Almisuifre/Malemort/Chronogrammes/Chronogramme PN Malemort/Chronogramme 1 (Brive vers Tulle).jpeg

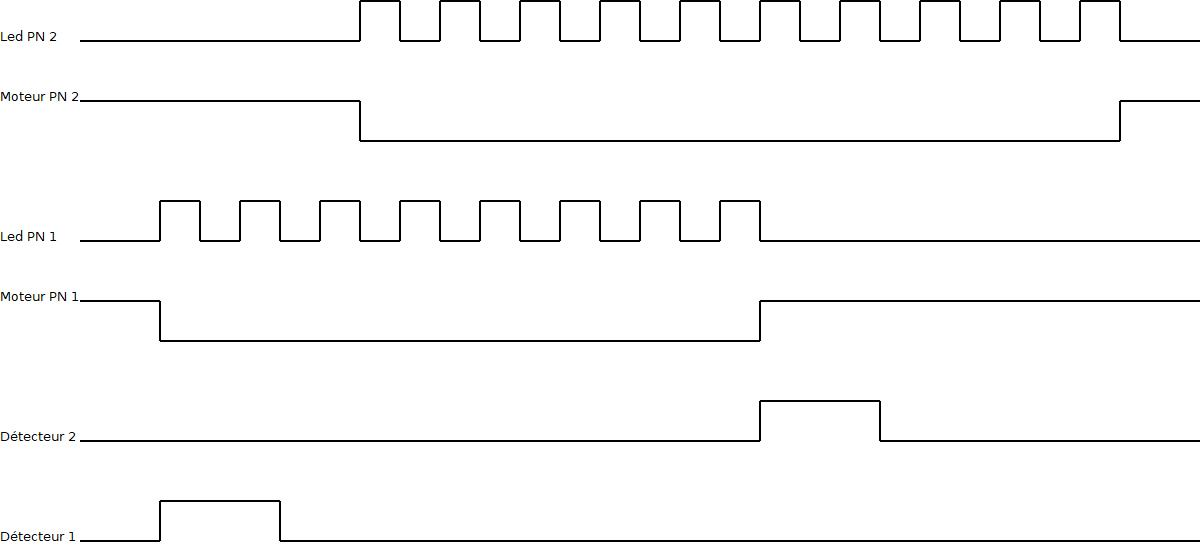
Chronogrammes/Chronogramme PN Malemort/Chronogramme 1 (Brive vers Tulle).jpeg
