Almisuifre/Malemort/Electronique/Eagle/DoublePN/DoublePN-11092017-001.brd

## EAGLE design Electronique/Eagle/DoublePN/DoublePN-11092017-001.brd (2017-09-15)

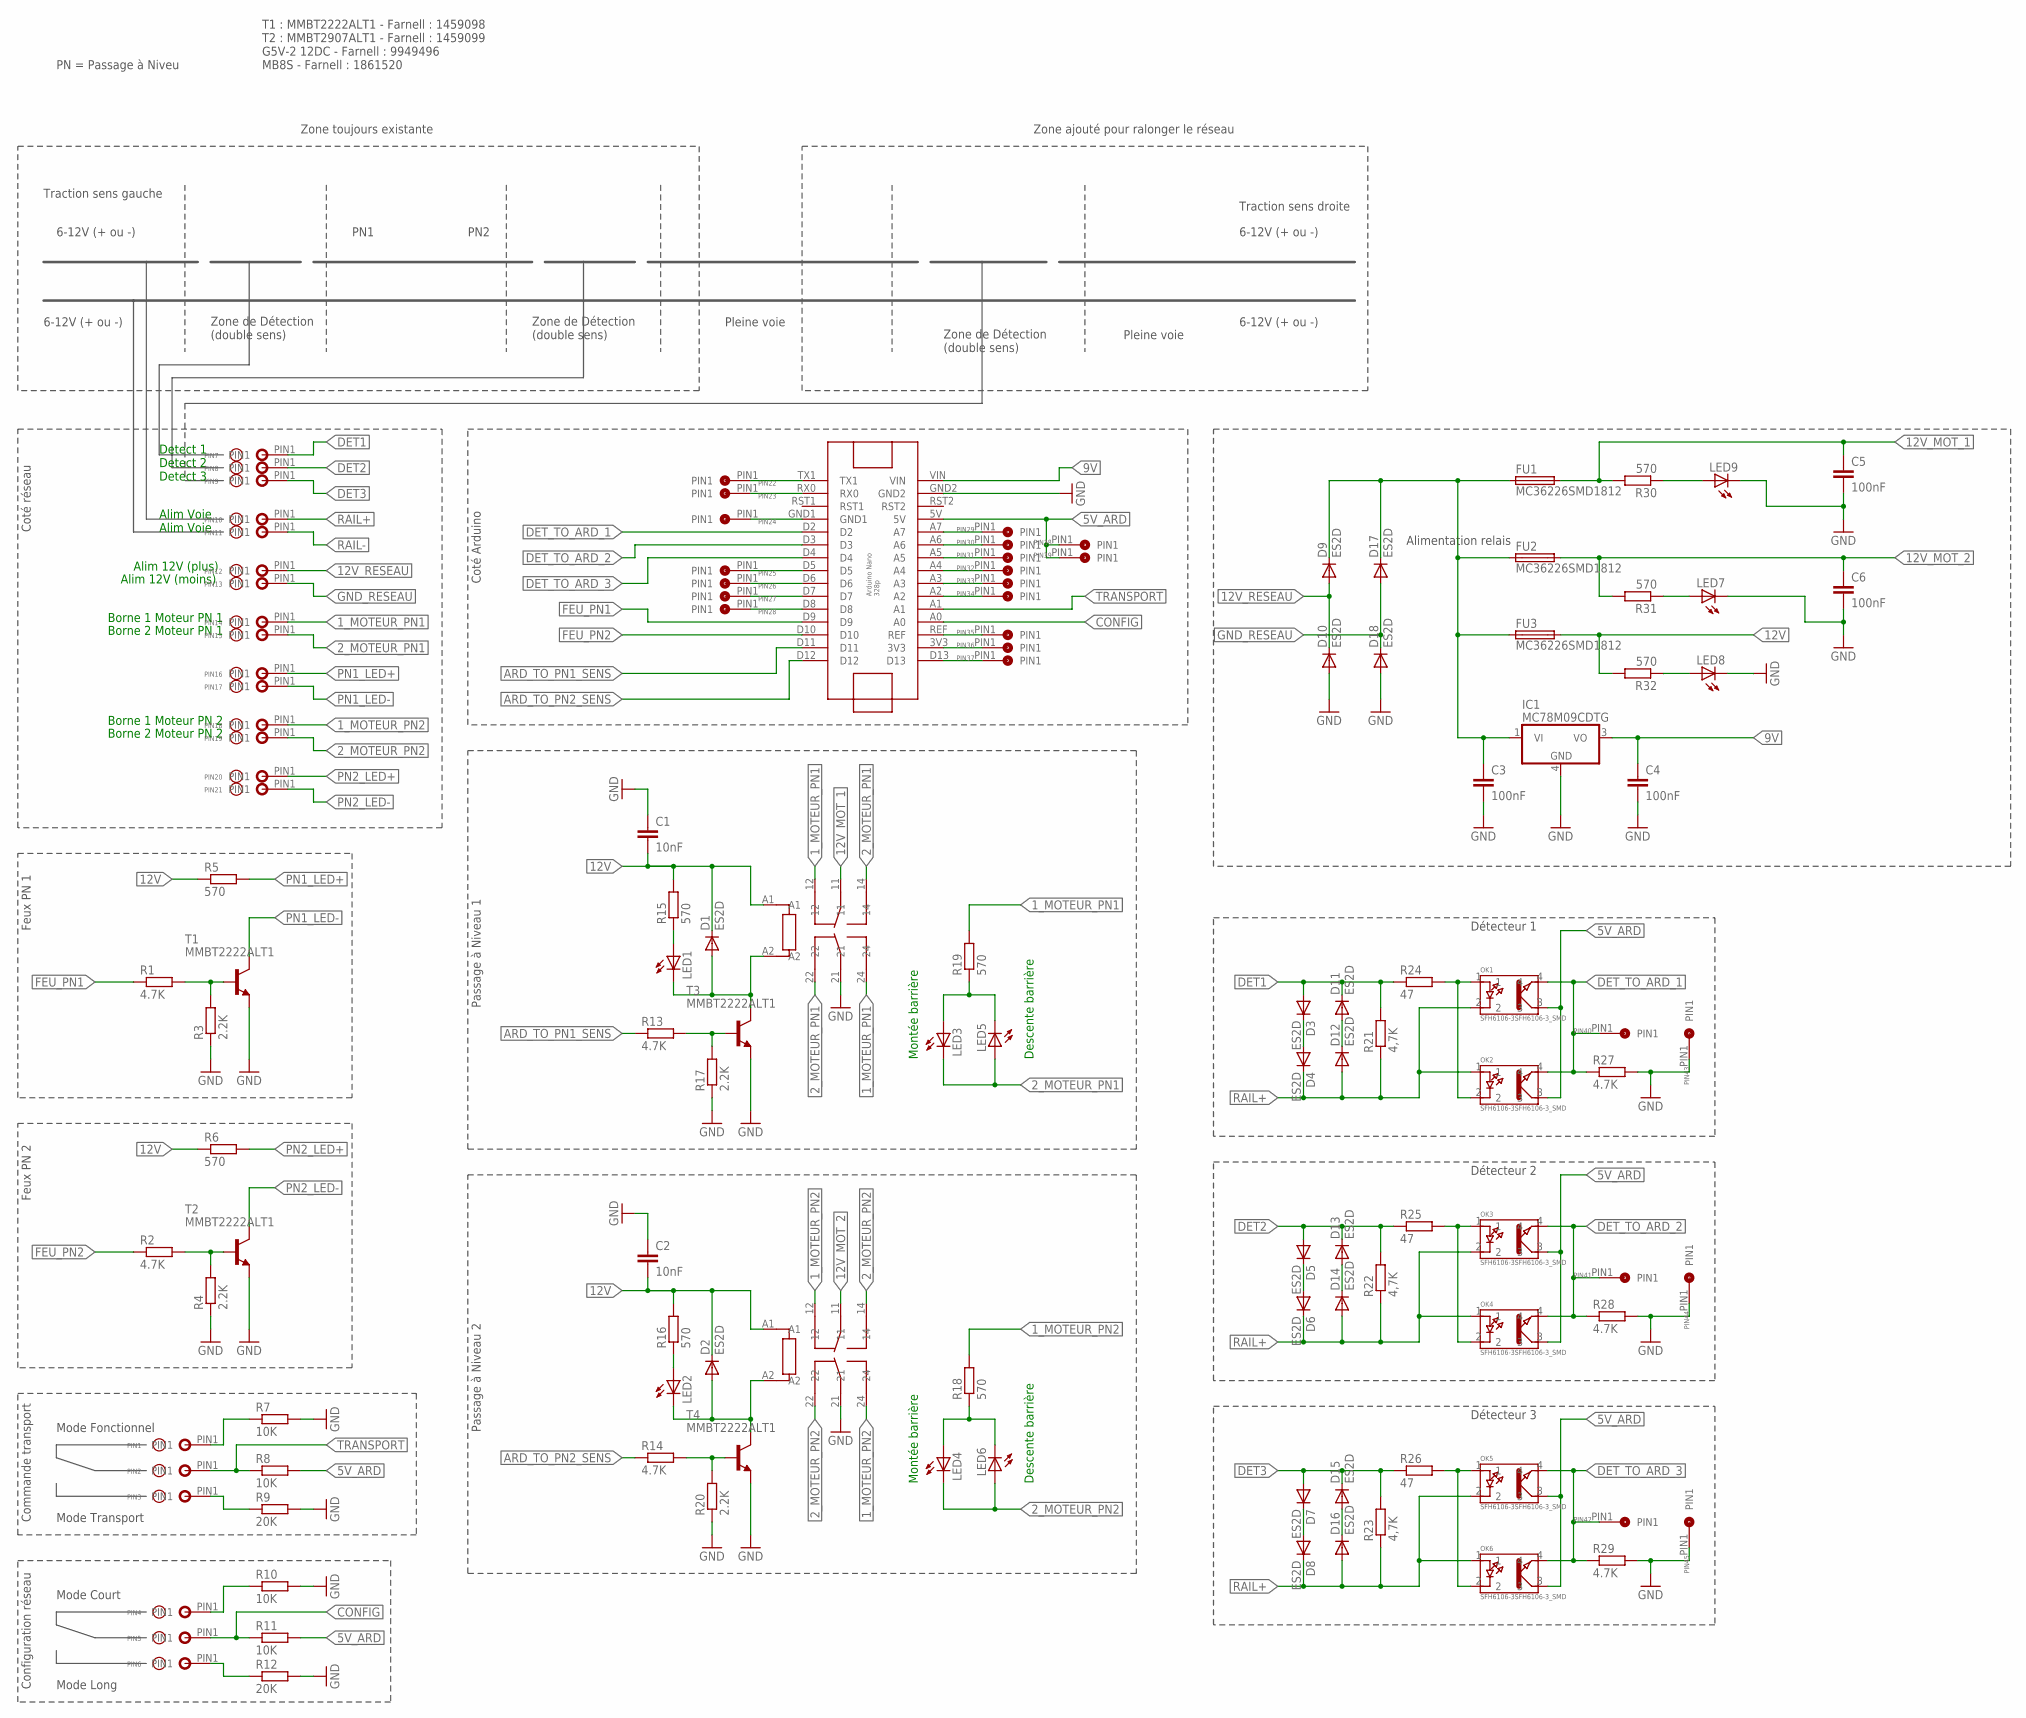
[picture p2: schematic DoublePN-11092017-001.sch]

Parts:
ARDUINO-NANO1: ARDUINO-NANO
C1, C2: 10nF; C0805
C3, C4, C5, C6: 100nF; C0805
D1, D2, D3, D4, D5, D6, D7, D8, D9, D10, D11, D12, D13, D14, D15, D16, D17, D18: ES2D; SMB
FU1, FU2, FU3: MC36226SMD1812; MC36226
IC1: MC78M09CDTG; DPACK_3
LED1, LED2, LED3, LED4, LED5, LED6, LED7, LED8, LED9: LEDCHIPLED_0805; CHIPLED_0805
OK1, OK2, OK3, OK4, OK5, OK6: SFH6106-3SFH6106-3_SMD; SFH6106-3
PIN1, PIN2, PIN3, PIN4, PIN5, PIN6, PIN7, PIN8, PIN9, PIN10, PIN11, PIN12, PIN13, PIN14, PIN15, PIN16, PIN17, PIN18, PIN19, PIN20, PIN21: CON-FILTRAVERSANT-1FILTRAVERSANT-1; CON-FILTRAVERSANT-1
PIN22, PIN23, PIN24, PIN25, PIN26, PIN27, PIN28, PIN29, PIN30, PIN31, PIN32, PIN33, PIN34, PIN35, PIN36, PIN37, PIN38, PIN39, PIN40, PIN41, PIN42, PIN43, PIN44, PIN45: CON-TRAV-1PIN; CON-TRAV-1
R1, R2, R13, R14, R27, R28, R29: 4.7K; R0805
R3, R4, R17, R20: 2.2K; R0805
R5, R6, R15, R16, R18, R19, R30, R31, R32: 570; R0805
R7, R8, R10, R11: 10K; R0805
R9, R12: 20K; R0805
R21, R22, R23: 4,7K; R0805
R24, R25, R26: 47; R0805
RLS1, RLS2: FINDER-DPDT-12VFINDER-DPDT-12V; FINDER-DPDT-12V
T1, T2, T3, T4: MMBT2222ALT1; SOT23-BEC

Connections:
1_MOTEUR_PN1: PIN14.PIN1, R19.2, RLS1.12, RLS1.24
1_MOTEUR_PN2: PIN18.PIN1, R18.2, RLS2.12, RLS2.24
2_MOTEUR_PN1: LED3.C, LED5.A, PIN15.PIN1, RLS1.14, RLS1.22
2_MOTEUR_PN2: LED4.C, LED6.A, PIN19.PIN1, RLS2.14, RLS2.22
5V_ARD: ARDUINO-NANO1.5V, OK1.3, OK2.3, OK3.3, OK4.3, OK5.3, OK6.3, PIN38.PIN1, PIN39.PIN1, R8.2, R11.2
9V: ARDUINO-NANO1.VIN, C4.1, IC1.3 (VO)
12V: C1.2, C2.2, D1.C, D2.C, FU3.2, R5.1, R6.1, R15.2, R16.2, R32.2, RLS1.A1, RLS2.A1
12V_MOT_1: C5.1, FU1.2, R30.2, RLS1.11
12V_MOT_2: C6.1, FU2.2, R31.2, RLS2.11
12V_RESEAU: D9.A, D10.C, PIN12.PIN1
ARD_TO_PN1_SENS: ARDUINO-NANO1.D11, R13.1
ARD_TO_PN2_SENS: ARDUINO-NANO1.D12, R14.1
CONFIG: ARDUINO-NANO1.A0, PIN5.PIN1, R11.1
DET1: D3.A, D11.C, PIN7.PIN1, R21.2, R24.1
DET2: D5.A, D13.C, PIN8.PIN1, R22.2, R25.1
DET3: D7.A, D15.C, PIN9.PIN1, R23.2, R26.1
DET_TO_ARD_1: ARDUINO-NANO1.D2, OK1.4, OK2.4, PIN40.PIN1, R27.1
DET_TO_ARD_2: ARDUINO-NANO1.D3, OK3.4, OK4.4, PIN41.PIN1, R28.1
DET_TO_ARD_3: ARDUINO-NANO1.D4, OK5.4, OK6.4, PIN42.PIN1, R29.1
FEU_PN1: ARDUINO-NANO1.D9, R1.1
FEU_PN2: ARDUINO-NANO1.D10, R2.1
GND: ARDUINO-NANO1.GND2, C1.1, C2.1, C3.2, C4.2, C5.2, C6.2, D10.A, D18.A, IC1.4 (GND), LED7.C, LED8.C, LED9.C, PIN43.PIN1, PIN44.PIN1, PIN45.PIN1, R3.1, R4.1, R7.2, R9.2, R10.2, R12.2, R17.1, R20.1, R27.2, R28.2, R29.2, RLS1.21, RLS2.21, T1.E, T2.E, T3.E, T4.E
GND_RESEAU: D17.A, D18.C, PIN13.PIN1
unnamed: OK1.1, OK2.2, R24.2
unnamed: D3.C, D4.A
unnamed: D11.A, D12.C
unnamed: LED3.A, LED5.C, R19.1
unnamed: R13.2, R17.2, T3.B
unnamed: D5.C, D6.A
unnamed: D1.A, LED1.C, RLS1.A2, T3.C
unnamed: D13.A, D14.C
unnamed: LED1.A, R15.1
unnamed: OK3.1, OK4.2, R25.2
unnamed: D7.C, D8.A
unnamed: D15.A, D16.C
unnamed: OK5.1, OK6.2, R26.2
unnamed: D2.A, LED2.C, RLS2.A2, T4.C
unnamed: LED9.A, R30.1
unnamed: LED4.A, LED6.C, R18.1
unnamed: R14.2, R20.2, T4.B
unnamed: LED2.A, R16.1
unnamed: ARDUINO-NANO1.GND1, PIN24.PIN1
unnamed: R2.2, R4.2, T2.B
unnamed: ARDUINO-NANO1.D7, PIN27.PIN1
unnamed: R1.2, R3.2, T1.B
unnamed: ARDUINO-NANO1.D8, PIN28.PIN1
unnamed: LED7.A, R31.1
unnamed: ARDUINO-NANO1.A7, PIN29.PIN1
unnamed: ARDUINO-NANO1.A6, PIN30.PIN1
unnamed: ARDUINO-NANO1.A5, PIN31.PIN1
unnamed: ARDUINO-NANO1.A4, PIN32.PIN1
unnamed: ARDUINO-NANO1.A3, PIN33.PIN1
unnamed: ARDUINO-NANO1.A2, PIN34.PIN1
unnamed: ARDUINO-NANO1.D6, PIN26.PIN1
unnamed: ARDUINO-NANO1.D5, PIN25.PIN1
unnamed: ARDUINO-NANO1.RX0, PIN23.PIN1
unnamed: ARDUINO-NANO1.TX1, PIN22.PIN1
unnamed: PIN4.PIN1, R10.1
unnamed: PIN1.PIN1, R7.1
unnamed: ARDUINO-NANO1.REF, PIN35.PIN1
unnamed: ARDUINO-NANO1.3V3, PIN36.PIN1
unnamed: ARDUINO-NANO1.D13, PIN37.PIN1
unnamed: PIN6.PIN1, R12.1
unnamed: PIN3.PIN1, R9.1
unnamed: C3.1, D9.C, D17.C, FU1.1, FU2.1, FU3.1, IC1.1 (VI)
unnamed: LED8.A, R32.1
PN1_LED+: PIN16.PIN1, R5.2
PN1_LED-: PIN17.PIN1, T1.C
PN2_LED+: PIN20.PIN1, R6.2
PN2_LED-: PIN21.PIN1, T2.C
RAIL+: D4.C, D6.C, D8.C, D12.A, D14.A, D16.A, OK1.2, OK2.1, OK3.2, OK4.1, OK5.2, OK6.1, PIN10.PIN1, R21.1, R22.1, R23.1
RAIL-: PIN11.PIN1
TRANSPORT: ARDUINO-NANO1.A1, PIN2.PIN1, R8.1

Notes on the sheet:
Alim Voie Alim Voie
Detect 1 Detect 2 Detect 3
Traction sens gauche
6-12V (+ ou -)
Traction sens droite
Zone toujours existante
Zone ajouté pour ralonger le réseau
PN2
PN1
PN = Passage à Niveu
Zone de Détection (double sens)
Pleine voie
Coté réseau
Coté Arduino
Détecteur 1
T1 : MMBT2222ALT1 - Farnell : 1459098 T2 : MMBT2907ALT1 - Farnell : 1459099 G5V-2 12DC - Farnell : 9949496 MB8S - Farnell : 1861520
Alim 12V (plus)
Alim 12V (moins)
Alimentation relais
Borne 1 Moteur PN 1
Borne 2 Moteur PN 1
Borne 2 Moteur PN 2
Borne 1 Moteur PN 2
Montée barrière
Descente barrière
Passage à Niveau 1
Feux PN 1
Mode Court
Mode Long
Configuration réseau
Mode Fonctionnel
Mode Transport
Commande transport
Détecteur 2
Détecteur 3
Feux PN 2
Passage à Niveau 2

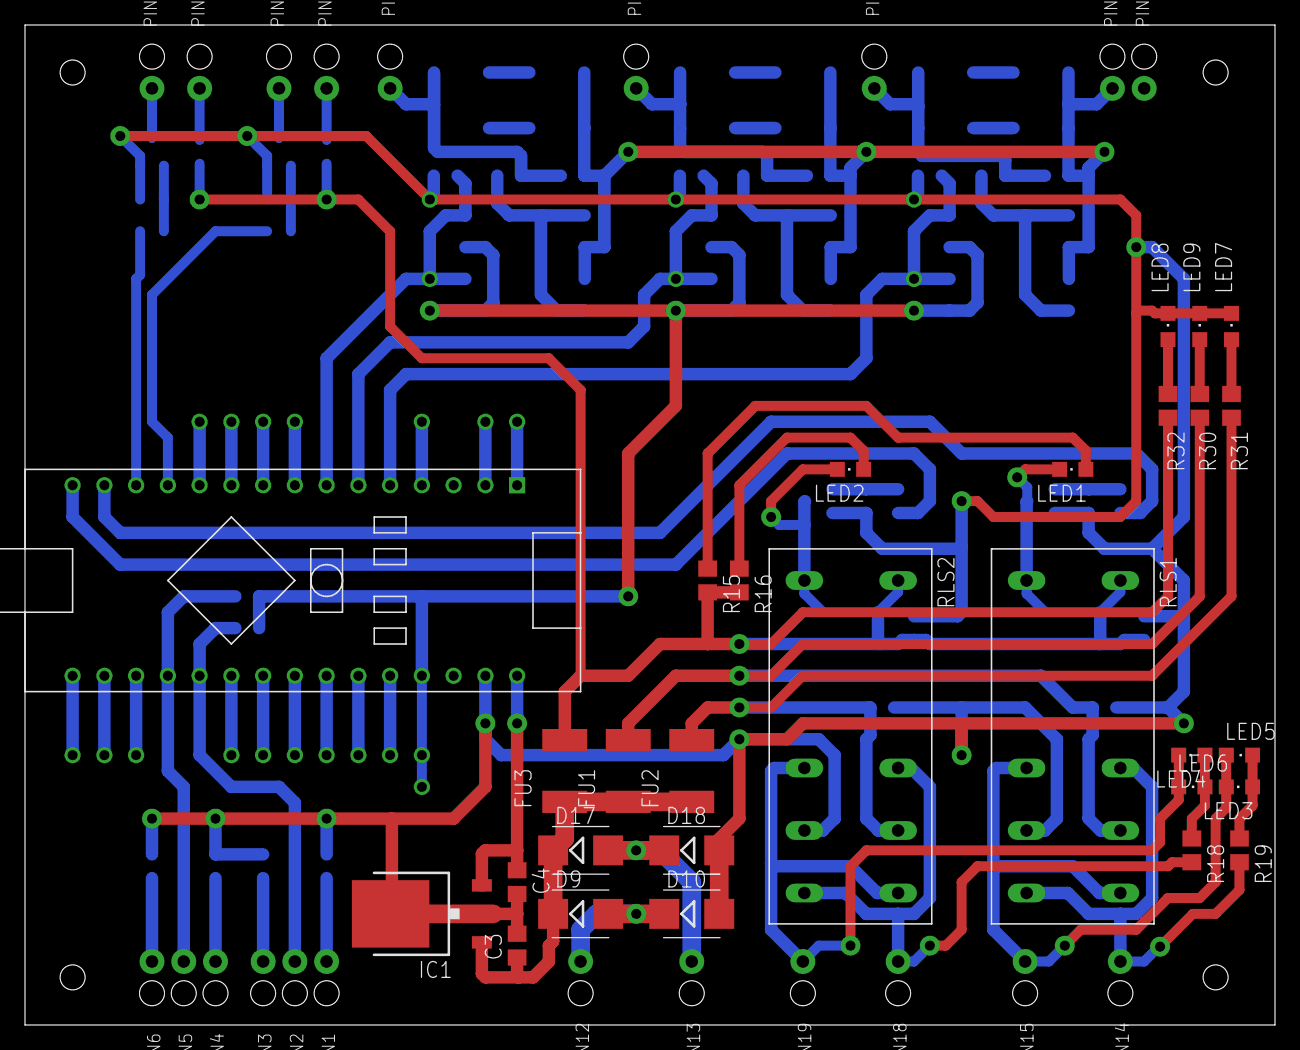
[picture p3: board DoublePN-11092017-001.brd from above]

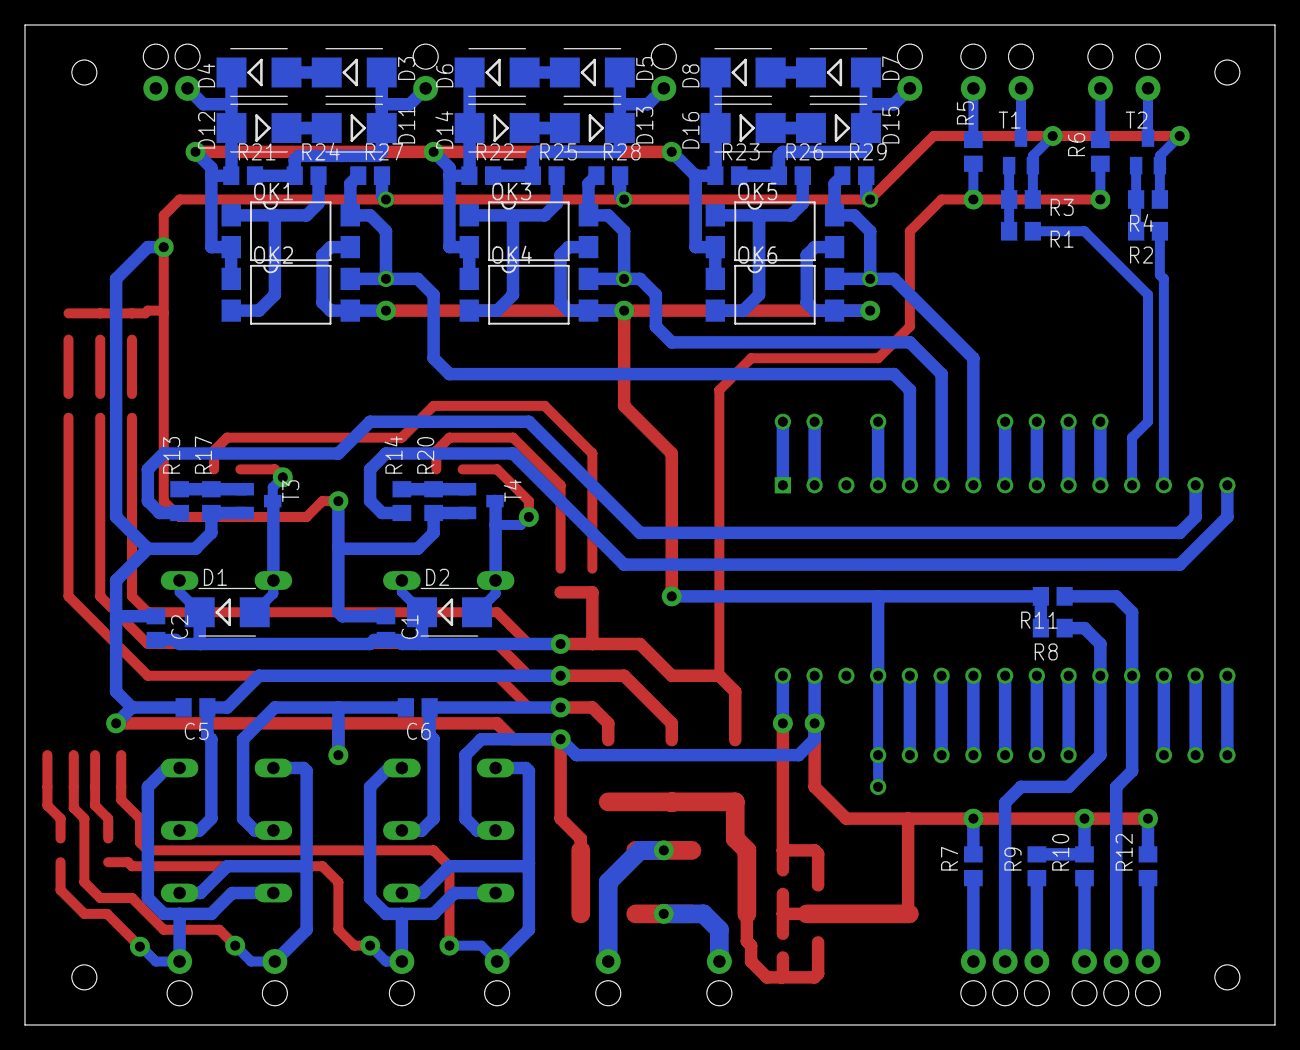
[picture p4: board DoublePN-11092017-001.brd from below]

Board: 2 copper layers, 100.0 x 80.0 mm, 127 parts (54 on the bottom side), 72 nets.
