Almisuifre/Malemort/Malemort1_0_0/masques_sequences.h

/* --- ZONE D'ARRET DES TRAINS / CANTONS -- */
boolean tZoneArret[NB_ZA];  //Tableau des état des zones d'arrets

//Séquence pour des trains manquant
//{ZA0,ZA1,ZA2,ZA3,ZA4,ZA5,ZA6}
boolean tMaskDefalutEmpty[NB_ZA] = {0,0,0,0,0,0,0};  //Toutes les zones d'arrets sont vides

//Séquence pour 1 train et 7 cantons
//{ZA0,ZA1,ZA2,ZA3,ZA4,ZA5,ZA6}
boolean tMaskTrain1Seq0[NB_ZA] = {1,0,0,0,0,0,0};  //ZA0 -> ZA1
boolean tMaskTrain1Seq1[NB_ZA] = {0,1,0,0,0,0,0};  //ZA1 -> ZA2 / ZA3
boolean tMaskTrain1Seq2[NB_ZA] = {0,0,1,0,0,0,0};  //ZA2 -> ZA4
boolean tMaskTrain1Seq3[NB_ZA] = {0,0,0,1,0,0,0};  //ZA3 -> ZA4
boolean tMaskTrain1Seq4[NB_ZA] = {0,0,0,0,1,0,0};  //ZA4 -> ZA5 / ZA6
boolean tMaskTrain1Seq5[NB_ZA] = {0,0,0,0,0,1,0};  //ZA5 -> ZA0
boolean tMaskTrain1Seq6[NB_ZA] = {0,0,0,0,0,0,1};  //ZA6 -> ZA0

//Séquence pour 2 trains et 7 cantons
boolean tMaskTrain2Seq0[NB_ZA] = {1,0,0,0,1,0,0};  //ZA0 -> ZA1
boolean tMaskTrain2Seq1[NB_ZA] = {0,1,0,0,1,0,0};  //ZA1 -> ZA2 / ZA3
boolean tMaskTrain2Seq2[NB_ZA] = {0,0,1,0,1,0,0};  //ZA4 -> ZA5 / ZA6
boolean tMaskTrain2Seq3[NB_ZA] = {0,0,0,1,1,0,0};  //ZA4 -> ZA5 / ZA6
boolean tMaskTrain2Seq4[NB_ZA] = {0,0,1,0,0,1,0};  //ZA5 -> ZA0
boolean tMaskTrain2Seq5[NB_ZA] = {0,0,1,0,0,0,1};  //ZA6 -> ZA0
boolean tMaskTrain2Seq6[NB_ZA] = {0,0,0,1,0,1,0};  //ZA5 -> ZA0
boolean tMaskTrain2Seq7[NB_ZA] = {0,0,0,1,0,0,1};  //ZA6 -> ZA0
boolean tMaskTrain2Seq8[NB_ZA] = {1,0,1,0,0,0,0};  //ZA2 -> ZA4
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

boolean tMaskTrain5Seq9[NB_ZA] = {1,1,0,1,1,0,1};  //ZA1 -> ZA2 / ZA3
boolean tMaskTrain5Seq10[NB_ZA] = {1,1,0,1,1,1,0};  //ZA1 -> ZA2 / ZA3

boolean tMaskTrain5Seq11[NB_ZA] = {1,1,1,0,1,0,1};  //ZA1 -> ZA2 / ZA3
boolean tMaskTrain5Seq12[NB_ZA] = {1,1,1,0,1,1,0};  //ZA1 -> ZA2 / ZA3
