Almisuifre/Malemort/(commit log)

2016-12-11 Add files via upload
    Ajout de la librairie FlexiTimer2
2017-01-22 Création dela nouvelle version réseau Malemort
    Création de la nouvelle version soft du réseau de train Malemort
2017-09-09 Create new sketch automatic independant
    Création d'un nouveau programme pour arduino nano. Gestion d'un double Pn disponible sur le réseau Malemort.
2017-09-10 Create new rep. Electronique and Eagle
    Création d'un répertoire nommé Electronique. A l'intérieur, se trouve les fichiers Eagle du montage.
    [DoublePN-03092017-001.brd, DoublePN-03092017-001.sch, DoublePN-OK.sch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]
2017-09-11 Remove electronic bad
    Remove electronic bad
    [DoublePN-03092017-001.brd, DoublePN-03092017-001.sch, DoublePN-OK.sch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]
2017-09-11 New Electronic Base
    New Electronic Base
    [DoublePN-11092017-001.sch]
2017-09-15 Nouvelle version
    Pour la nouvelle carte. Nouvelle version soft !
2017-09-15 Mise à jour carte
    Mise à jour carte
    [DoublePN-11092017-001.brd, DoublePN-11092017-001.sch]
2017-09-17 Add chronogram
    Ajout des chronogrammes
2017-09-17 Add dia chronogram
    Ajout des cronogrammes utilisable avec le logiciel DIA
2018-04-17 Schéma
    Mise à jour du schéma DB25 raccordement réseau
    [Schémas raccordements DB25.ods]
